Rusic850/MK85-Reload-/README.md

# MK85-Reload-
New Elektronika MK-85 files;

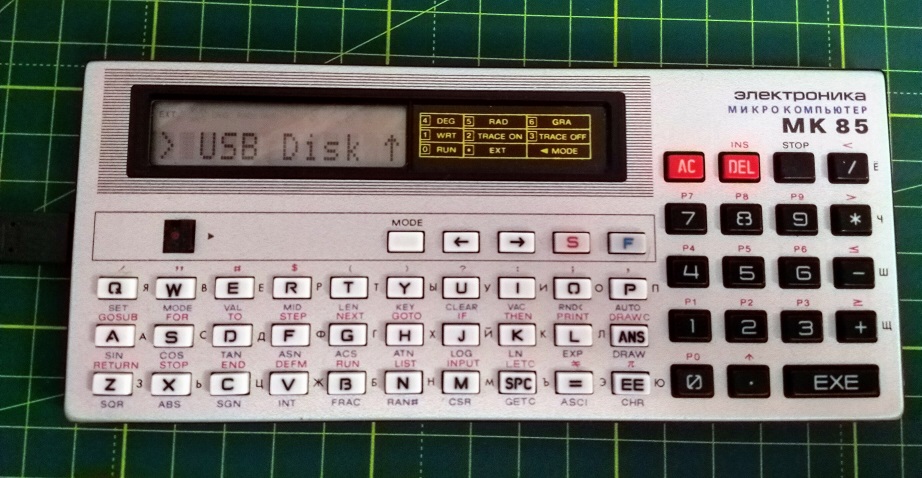
[picture p1: Pictures/IMG_20201219_152831~2.jpg]
MK85Reload


Файлы для модернизации калькулятора Электроника МК-85; 

Переделки обозначенные разными цветами могут производиться независимо друг от друга

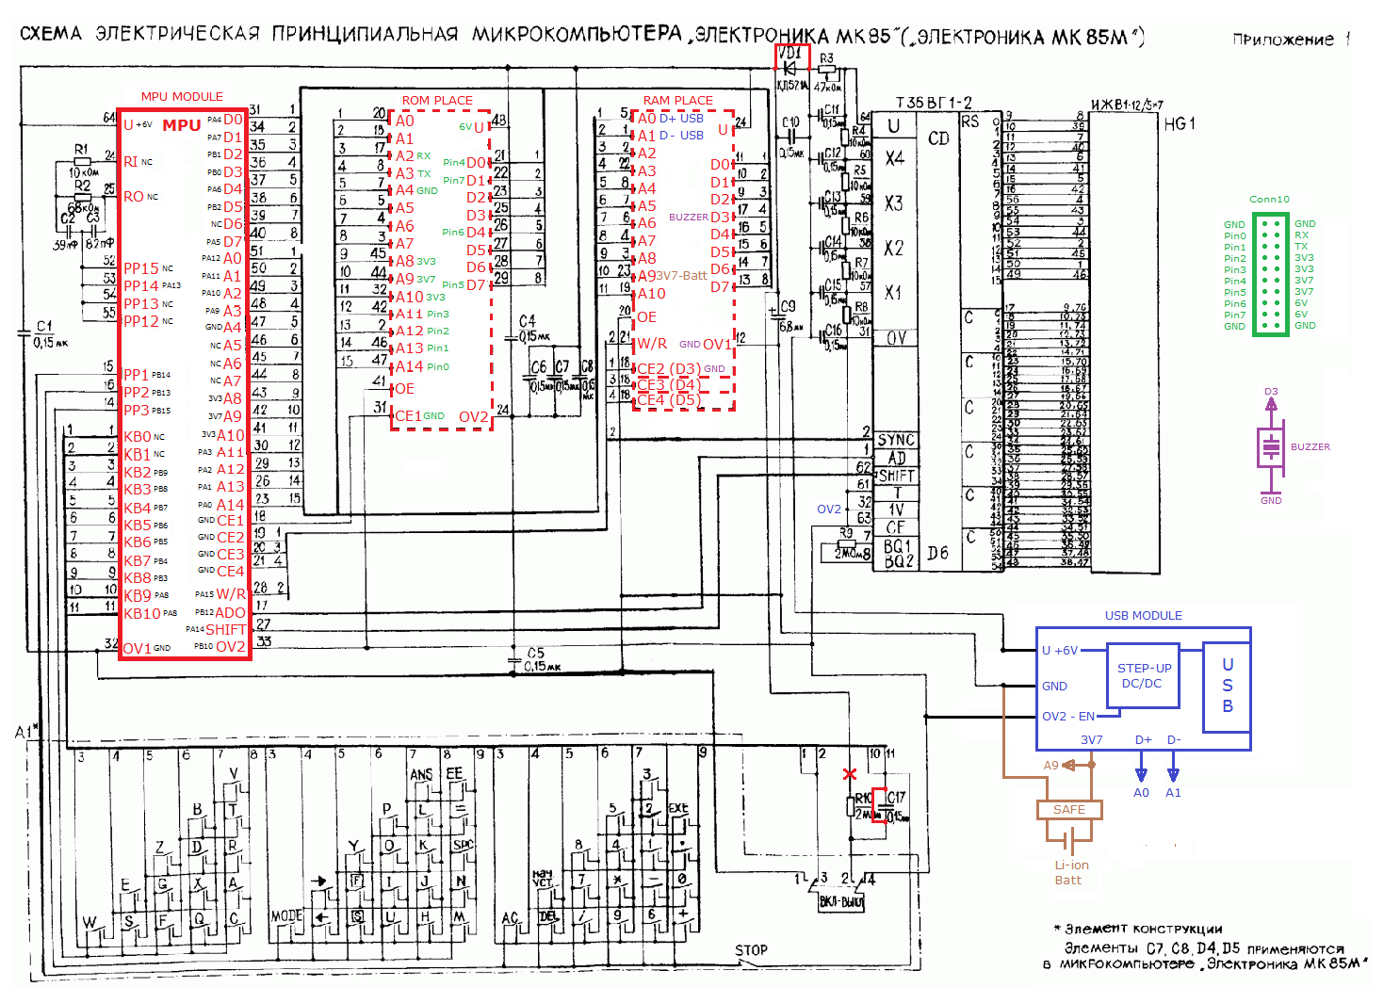
[picture p2: Schematic-Reload.png]
SCH


Необходимые изменения на плате калькулятора

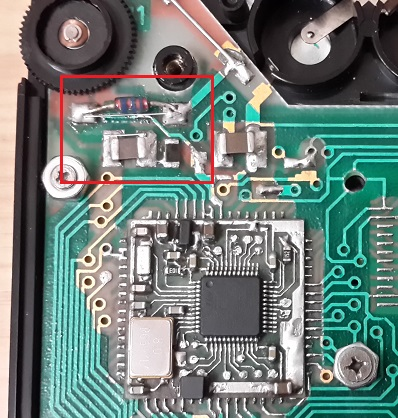
[picture p3: Pictures/Remake.jpg]


Разводка печатных плат выполнена в Sprint Layout 6;

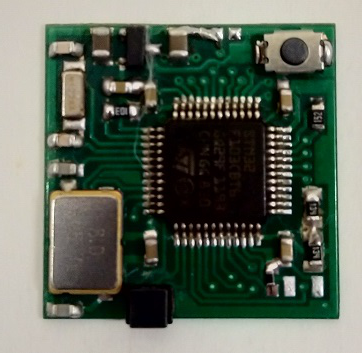
[picture p4: Pictures/MPU-Mod.jpg]
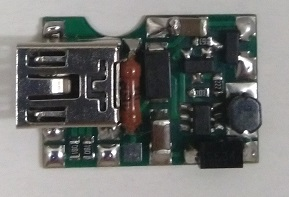
[picture p5: Pictures/USB-Mod.jpg]
USBpcb
 

Печатные платы толщиной 0,5мм;

Модуль MCU паяется на высоте 0,5мм от материнской платы;
К модулю USB необходимо припаять проводки, а затем производить монтаж;

Необходимо удалить ножку +6В на корпус калькулятора;

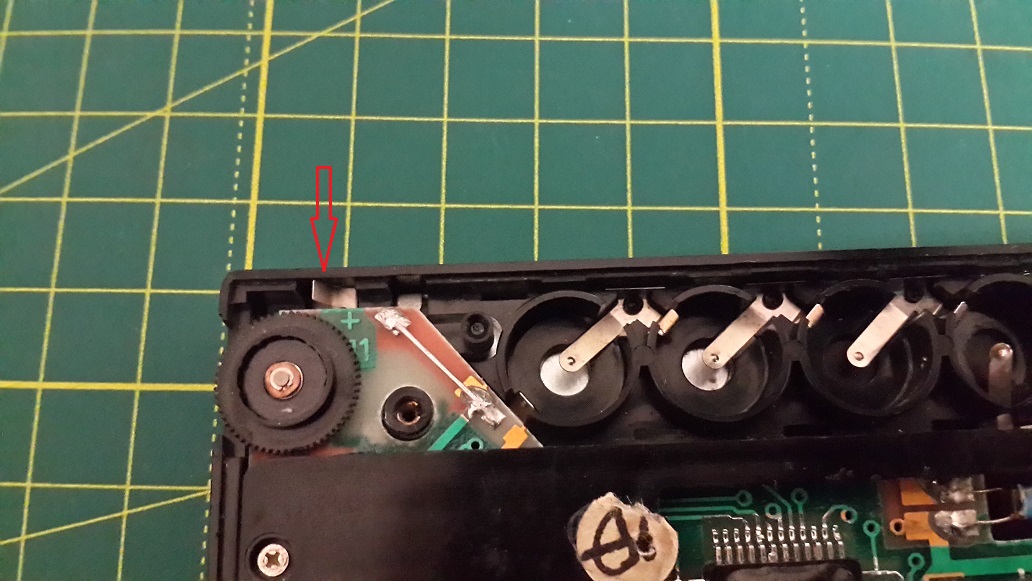
[picture p6: Pictures/Lapka.jpg]
Lapka


Аккумулятор Li-ion ёмкостью 250mAh (минимум) с платой защиты;

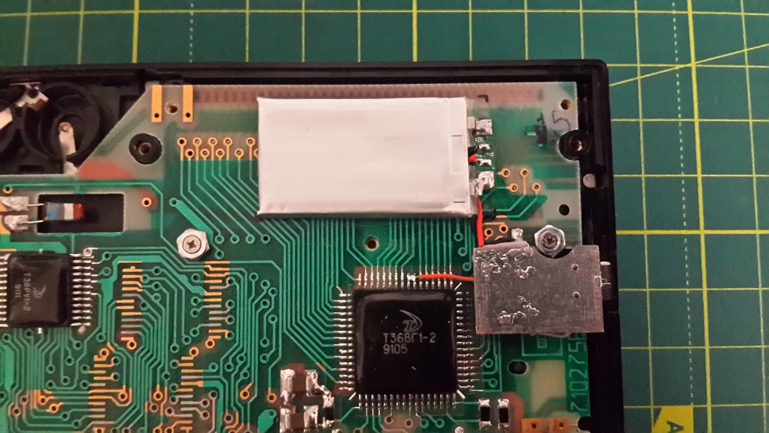
[picture p7: Pictures/USBmod2.jpg]
BATT


Идеально в устройство станет разьём microUSB, однако, я его считаю крайне неудачным и предпочитаю подпилить держатель, но установить miniUSB

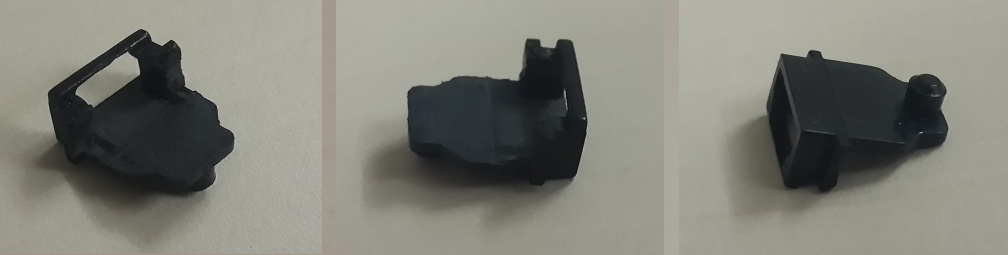
[picture p8: Pictures/PlasticUSB.jpg]
usb


**All.bin** содержит загрузчик и ПО; 

**System.bin** последняя прошивка v0002 (обновляется через загрузчик);

Если загружено не верное ПО, необходимо включить калькулятор, зажать любую цифровую клавишу и нажать RESET MPU для перезапуска загрузчика!
