Rusic850/MK85-Reload-/Original-MK85-/readme.md

## Документация по оригинальному калькулятору Электроника МК-85
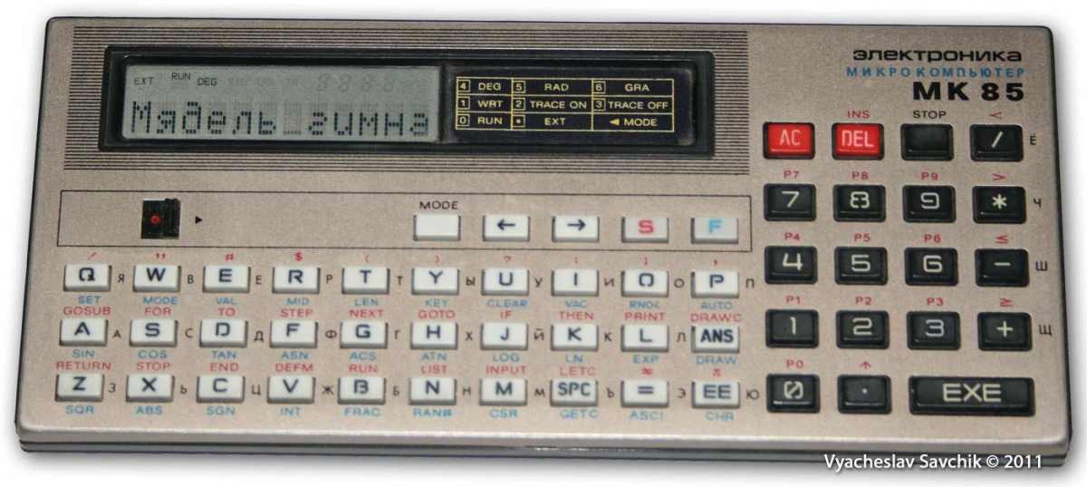
[picture p9: Original-MK85-/MK85_b.jpg]

## Схема калькулятора
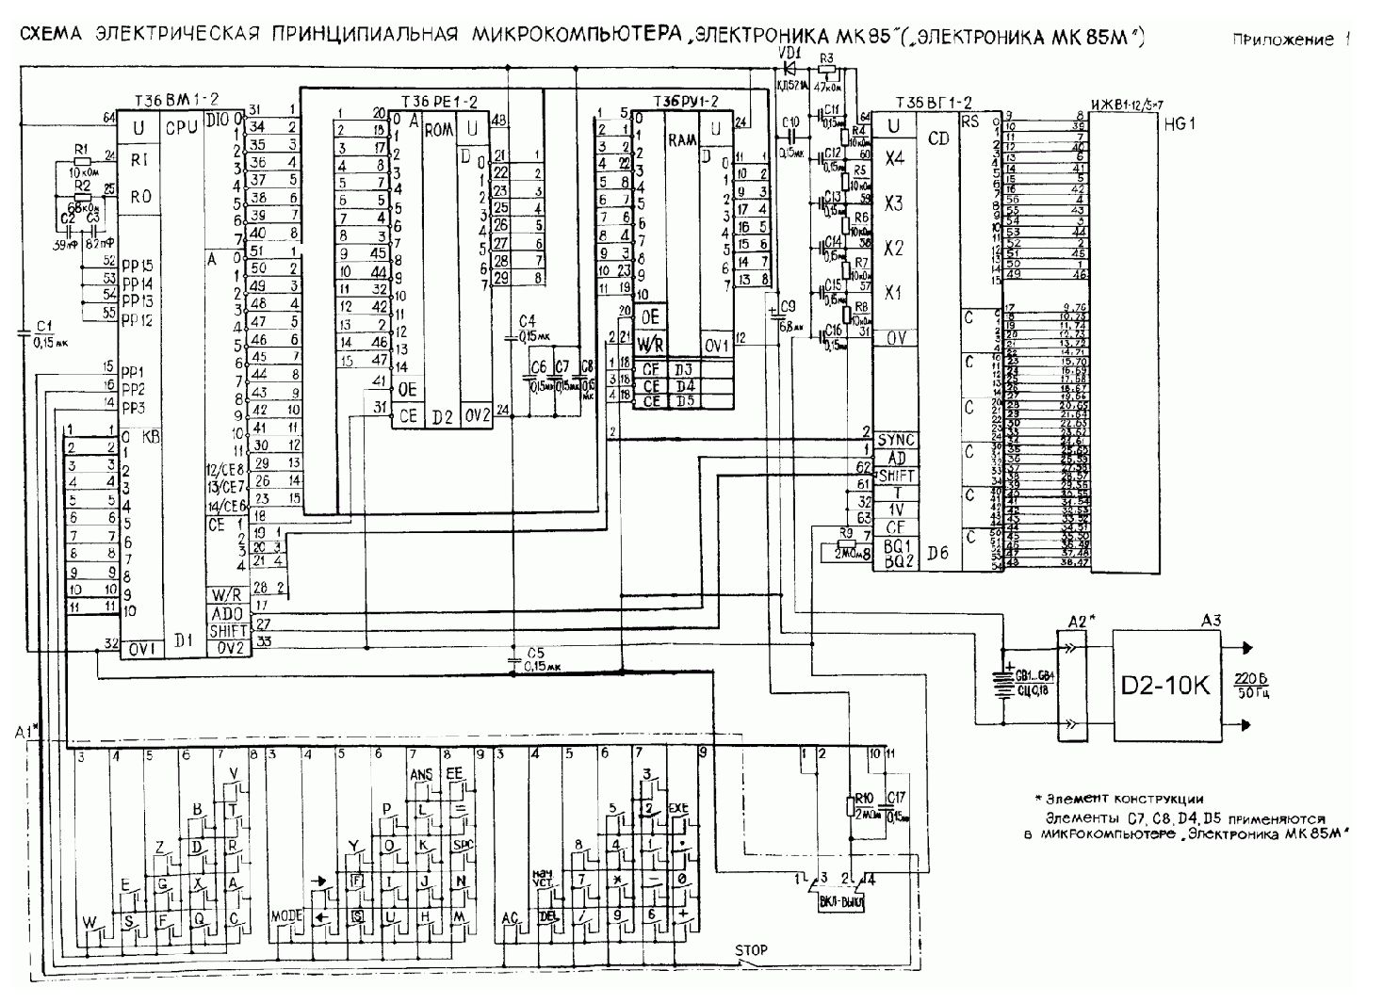
[picture p10: Original-MK85-/Schematic.png]
Схема

## Комплектация
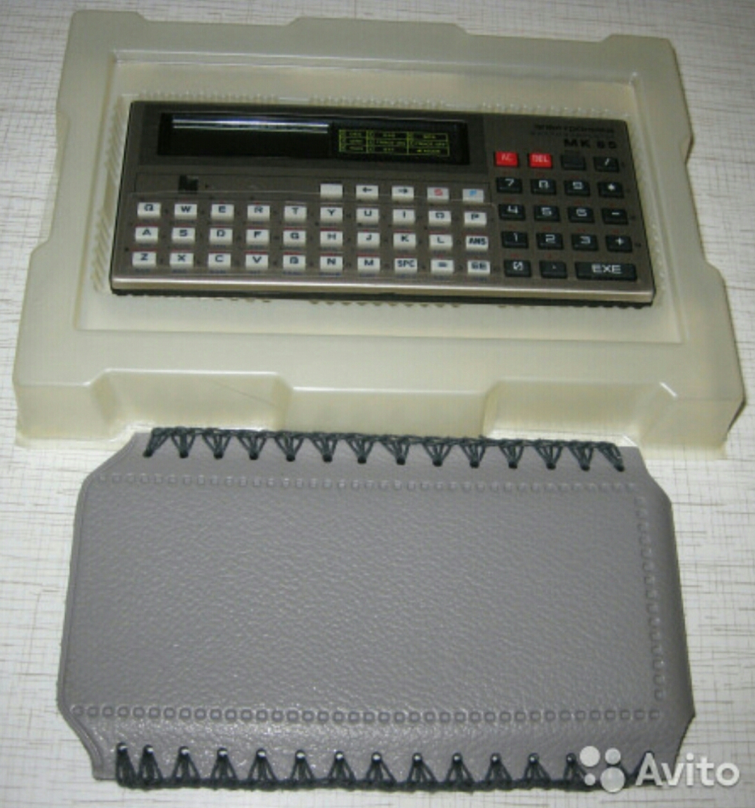
[picture p11: Original-MK85-/Screenshot_2019-08-17-19-20-43.jpg]

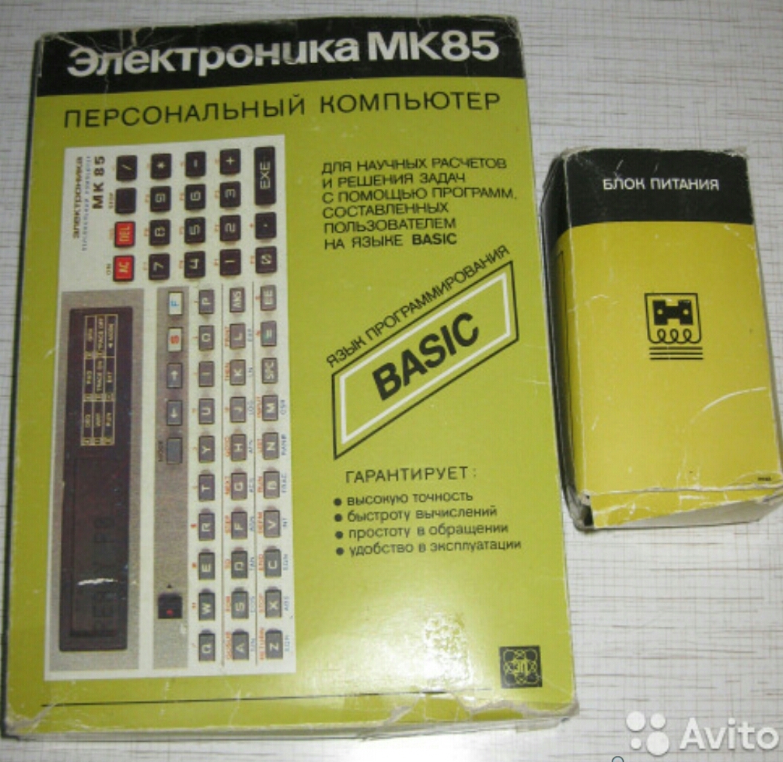
[picture p12: Original-MK85-/tempFile_2019-08-17-19-19-57.jpg]

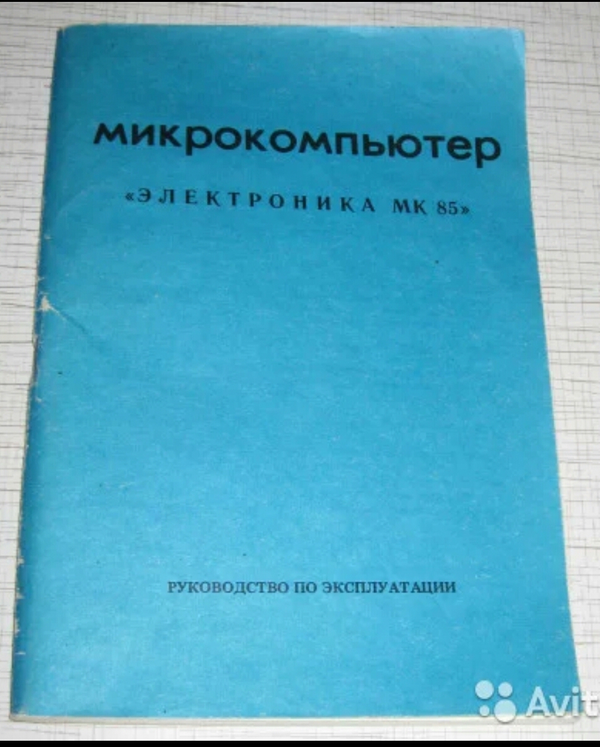
[picture p13: Original-MK85-/tempFile_2019-08-17-19-19-30.jpg]
