Rusic850/MK85-Reload-/Conn10.png

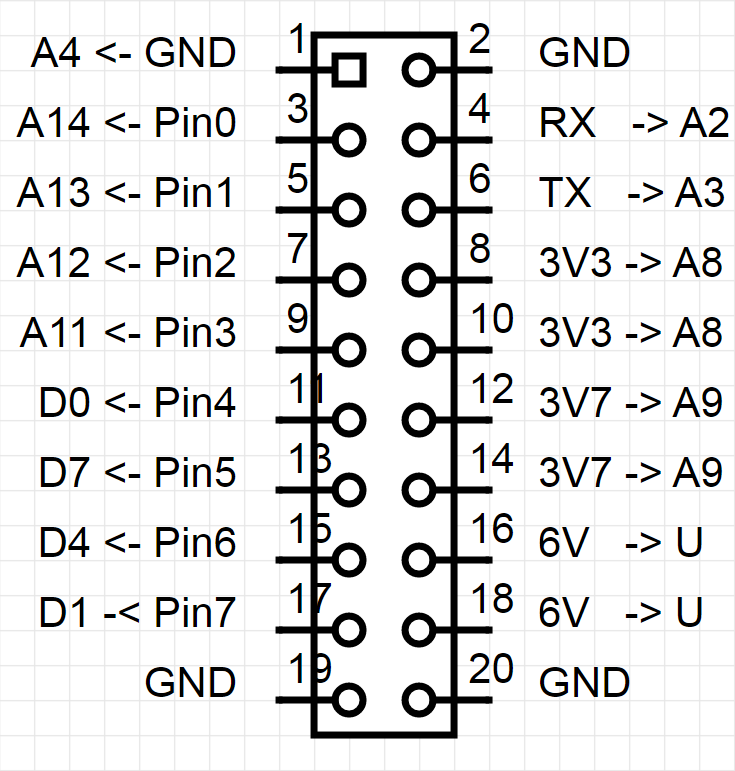
Conn10.png
