Rusic850/MK85-Reload-/mk85cpu.png

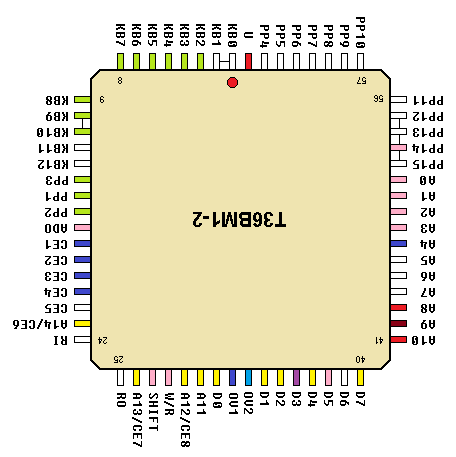
mk85cpu.png
