Rusic850/MK85-Reload-/MPU.png

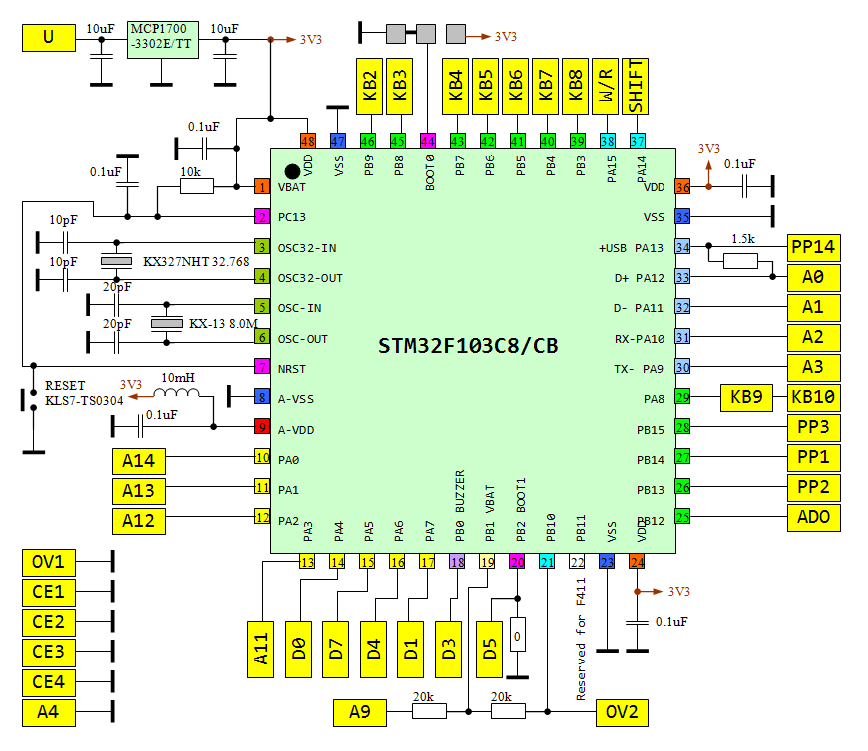
MPU.png
