Rusic850/MK85-Reload-/Original-MK85-/Screenshot_2019-08-17-19-20-20.jpg

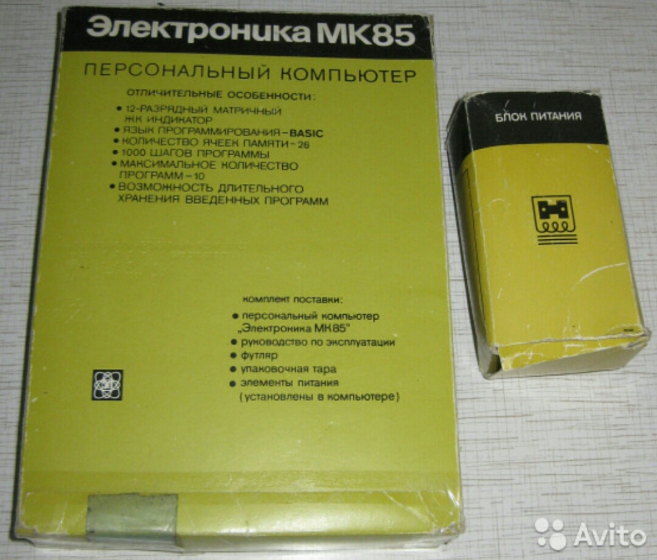
Original-MK85-/Screenshot_2019-08-17-19-20-20.jpg
