Rusic850/MK85-Reload-/Pictures/Connector.jpg

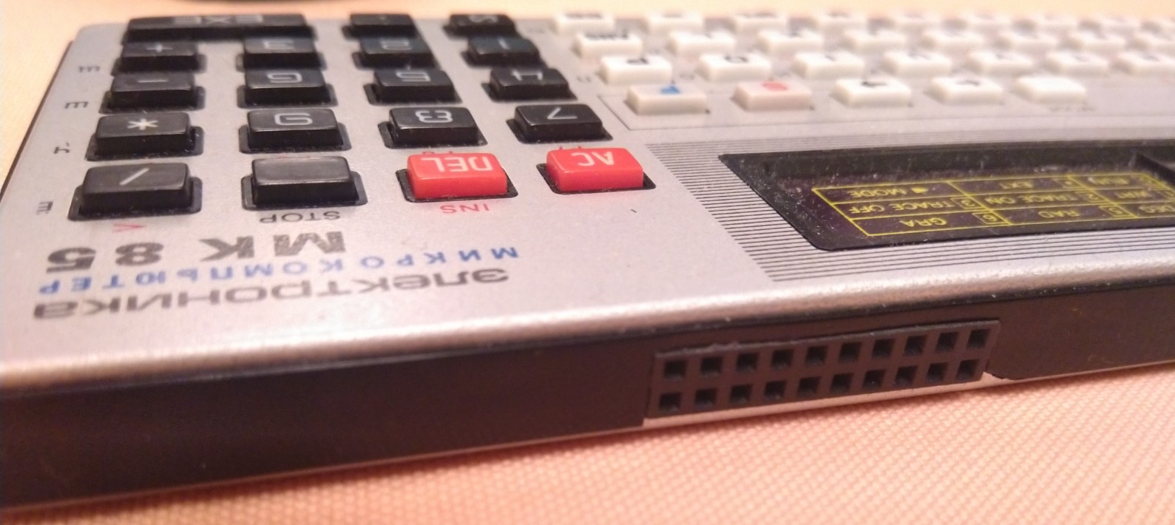
Pictures/Connector.jpg
