Rusic850/MK85-Reload-/Pictures/Cover.jpg

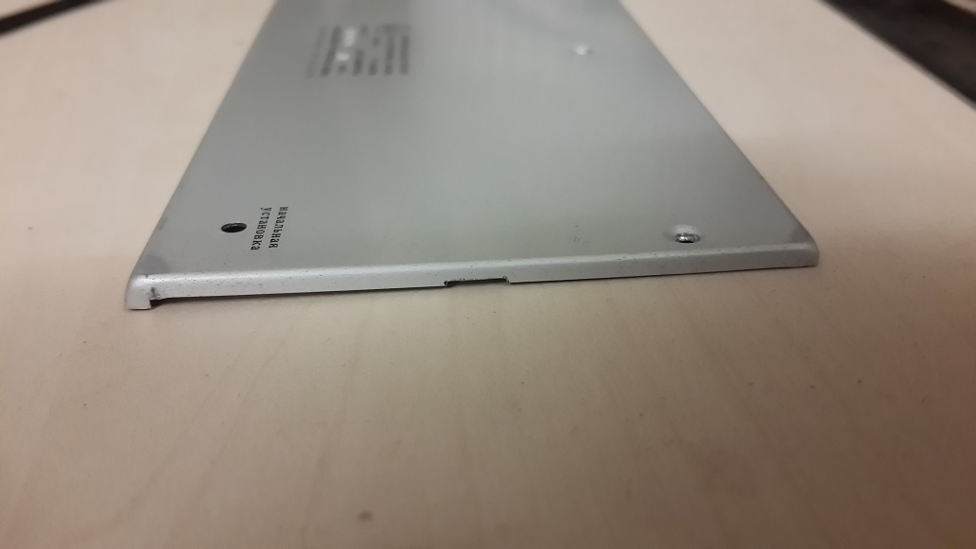
Pictures/Cover.jpg
