Rusic850/MK85-Reload-/Pictures/CoverIn.jpg

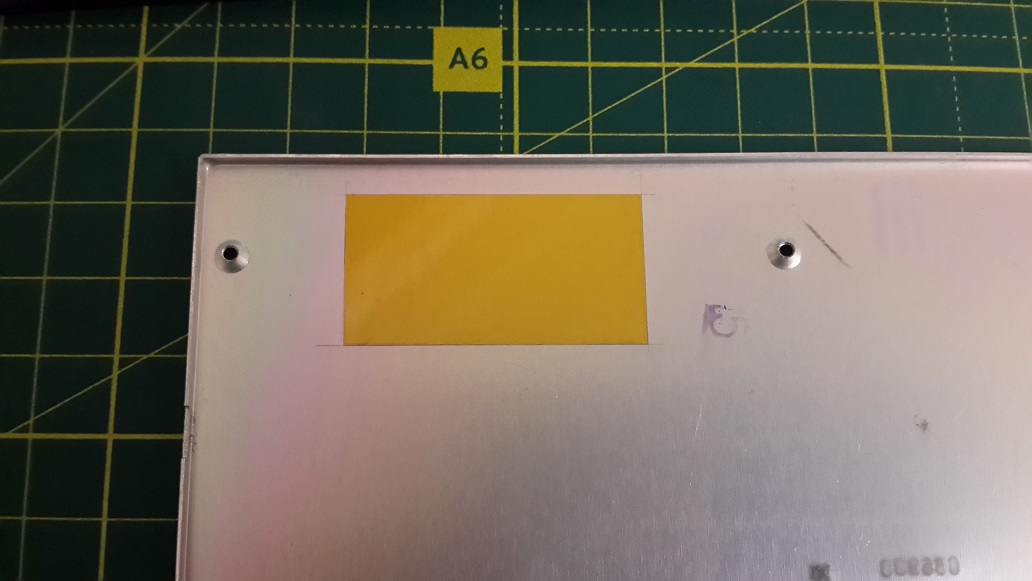
Pictures/CoverIn.jpg
