Rusic850/MK85-Reload-/Pictures/MotherB.jpg

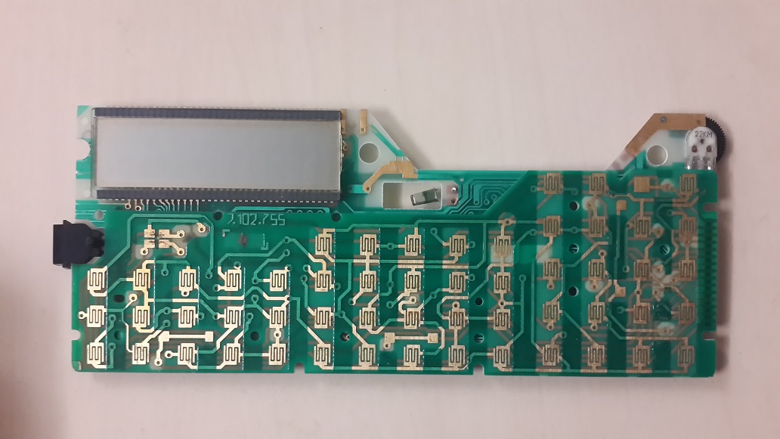
Pictures/MotherB.jpg
