Rusic850/MK85-Reload-/Pictures/MPU-back.jpg

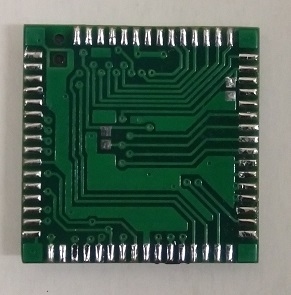
Pictures/MPU-back.jpg
