Rusic850/MK85-Reload-/Pictures/MPU-PCB.jpg

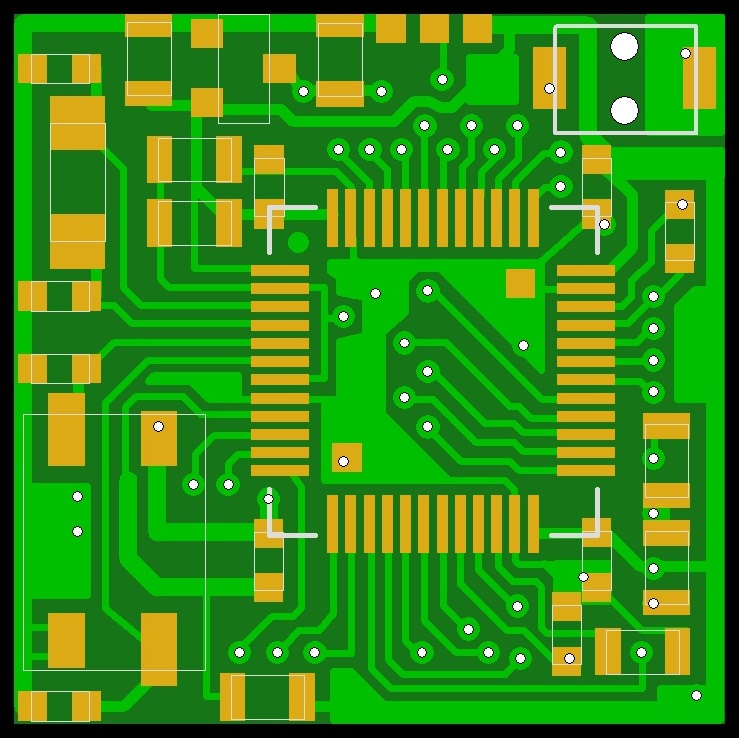
Pictures/MPU-PCB.jpg
