Rusic850/MK85-Reload-/Pictures/OnlyUSB.jpg

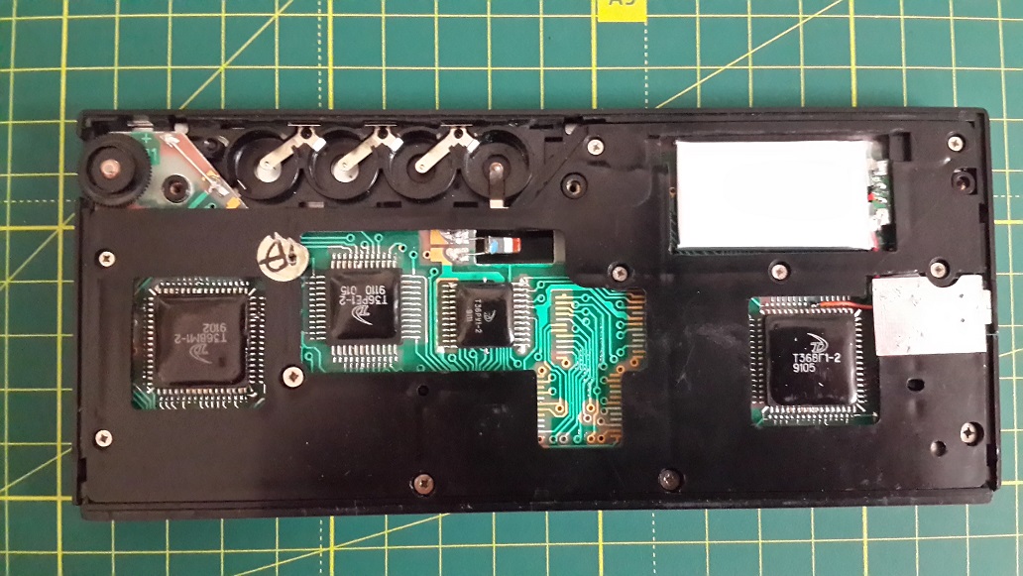
Pictures/OnlyUSB.jpg
