Rusic850/MK85-Reload-/Pictures/USB-PCB.jpg

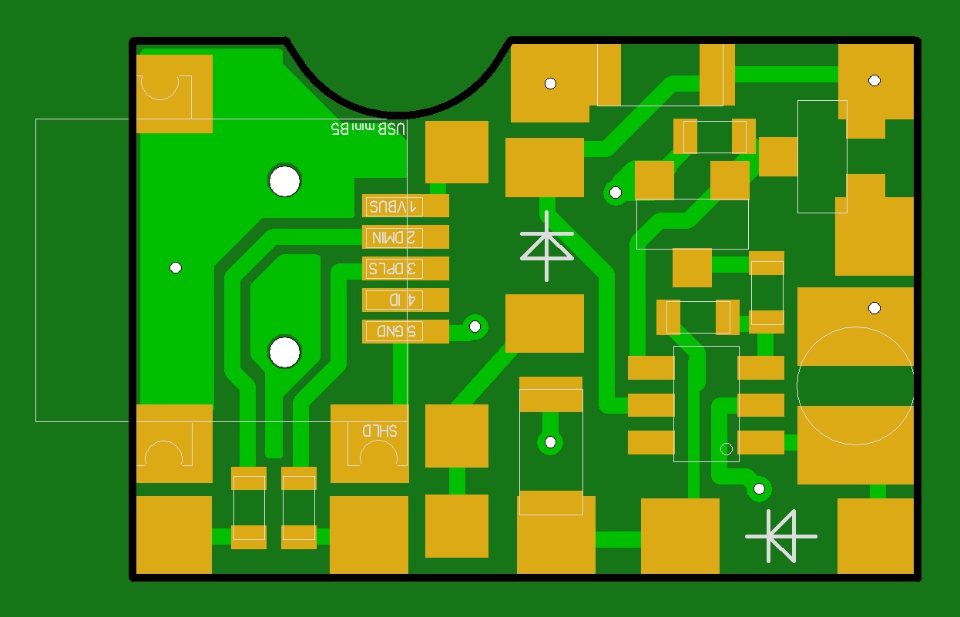
Pictures/USB-PCB.jpg
