Rusic850/MK85-Reload-/Pictures/USBin.jpg

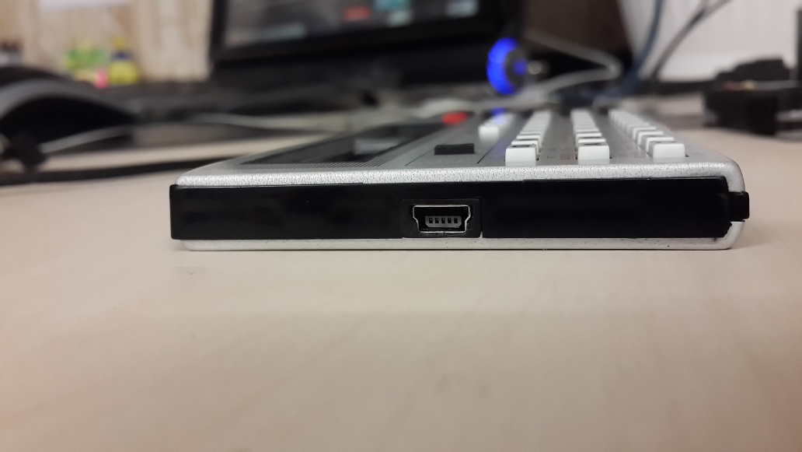
Pictures/USBin.jpg
