Rusic850/MK85-Reload-/Pictures/USBmod.jpg

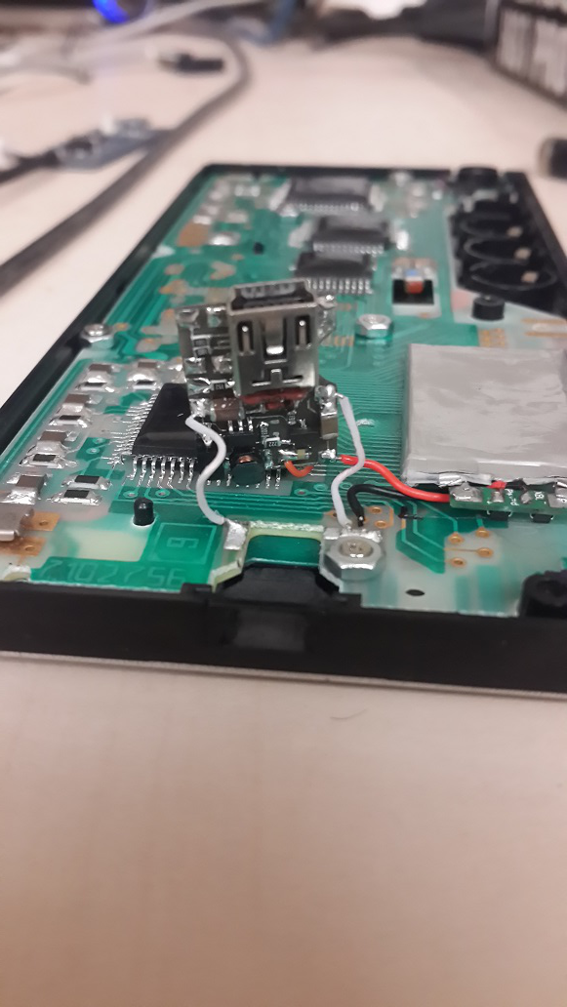
Pictures/USBmod.jpg
