Rusic850/MK85-Reload-/USB.jpg

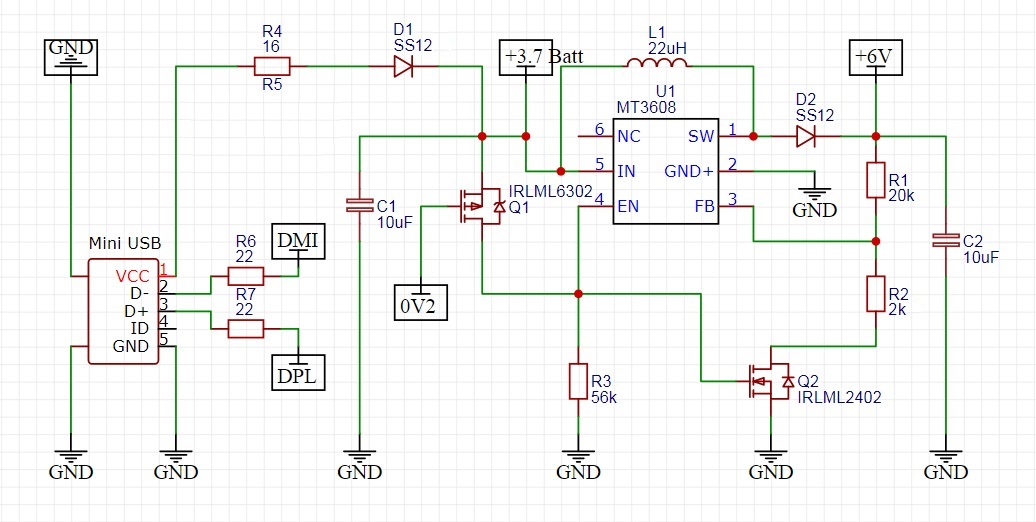
USB.jpg
