Rusic850/MK85-Reload-/(list of files, drawings)

Other design files:
MK-85-CPU.lay
MK-85-USB.lay
